jie326513988/esp32-c3-1.54-epd/(list of files, drawings)

Other design files:
ProProject_ESP32C3-1.54墨水屏-多功能_2024-05-25.epro
