jie326513988/esp32-c3-1.54-epd/(commit log)

2024-05-25 可视化BOM
2024-05-25 立创EDA工程文件
    [ProProject_ESP32C3-1.54墨水屏-多功能_2024-05-25.epro]
2024-05-25 删除文件 README.en.md
2024-05-25 新建 图片
2024-05-25 上传图片
2024-05-25 删除文件 图片/.keep
2024-05-26 3D打印外壳
2024-05-26 删除文件 .gitignore
2024-05-26 删除文件 ESP32C3-1.54EPD-SSD1608-V019.bin
2024-05-26 删除文件 ESP32C3-1.54EPD-SSD1681-V019.bin
2024-05-26 更新固件 修复图片查看器切换目录BUG
2024-05-27 删除文件 图片/烧录.png
2024-06-09 删除文件 ESP32C3-1.54EPD-SSD1608-V020.bin
2024-06-09 删除文件 ESP32C3-1.54EPD-SSD1681-V020.bin
2024-06-09 更新固件 章节列表上下页选项优化，不再乱跳 章节检索优化 闹钟列表有下一页了
2024-06-12 删除文件 ESP32C3-1.54EPD-SSD1608-V021.bin
2024-06-12 删除文件 ESP32C3-1.54EPD-SSD1681-V021.bin
2024-06-12 更新固件 优化配网性能，修复一句话表单提交后卡死BUG
2024-06-20 更新固件
2024-06-20 删除文件 ESP32C3-1.54EPD-SSD1681-V023-新增寻章功能.bin
2024-08-18 删除文件 ESP32C3-1.54EPD-SSD1681-V022.bin
2024-08-18 删除文件 ESP32C3-1.54EPD-SSD1608-V023-新增寻章功能.bin
2024-08-18 删除文件 ESP32C3-1.54EPD-SSD1608-V022.bin
2024-08-18 更新固件 1.所有列表界面按键逻辑更改，短按OK进入，短按BACK返回，短按UP/DOWN切换选项，长按UP/DOWN切换页 2.优化阅读和菜单按键逻辑，阅读界面长按BACK退出至文件管理器，短按BACK开灯，阅读菜单继续选项更改为章节选项 3.修复打开非jpg重命名的文件导致内存溢出无限重启问题
2024-08-18 删除文件 图片/按键提示.jpg
2024-08-18 修改按键提示
2024-10-14 重命名 ESP32C3-1.54EPD-SSD1608-V026.bin 为 ESP32C3-1.54EPD-SSD1608-V026_支持GBK.bin
2024-10-14 重命名 ESP32C3-1.54EPD-SSD1681-V026.bin 为 ESP32C3-1.54EPD-SSD1681-V026_支持GBK.bin
2024-10-27 删除文件 ESP32C3-1.54EPD-SSD1608-V026_支持GBK.bin
2024-10-27 删除文件 ESP32C3-1.54EPD-SSD1681-V026_支持GBK.bin
2024-10-27 优化GBK&UTF8识别
2025-03-03 删除文件 焊接辅助工具-0.6.html
2025-03-03 焊接辅助工具
2025-04-13 更新固件 1.优化EPUB兼容性，增加按键自定义功能
2025-04-13 更新固件 优化EPUB兼容性，增加按键自定义
2025-04-13 删除文件 ESP32C3-1.54EPD-SSD1681-V028_优化EPUB增加按键自定义.bin
2025-04-13 删除文件 ESP32C3-1.54EPD-SSD1608-V028_优化EPUB增加按键自定义.bin
2025-05-01 删除文件 ESP32C3-1.54EPD-SSD1608-V027_优化GBK&UTF8识别.bin
2025-05-01 删除文件 ESP32C3-1.54EPD-SSD1608-V029_优化EPUB增加按键自定义.bin
2025-05-01 删除文件 ESP32C3-1.54EPD-SSD1681-V027_优化GBK&UTF8识别.bin
2025-05-01 删除文件 ESP32C3-1.54EPD-SSD1681-V029_优化EPUB增加按键自定义.bin
2025-05-02 删除文件 ESP32C3-1.54EPD-SSD1681-V030_全新EPUB算法修复激活BUG.bin
2025-05-02 删除文件 ESP32C3-1.54EPD-SSD1608-V030_全新EPUB算法修复激活BUG.bin
2025-05-11 删除文件 ESP32C3-1.54EPD-SSD1681-V031_全新EPUB算法修复激活BUG.bin
2025-05-11 删除文件 ESP32C3-1.54EPD-SSD1608-V031_全新EPUB算法修复激活BUG.bin
2025-05-11 删除文件 ESP32C3-1.54EPD-SSD1681-V032_优化EPUB.bin
2025-05-11 删除文件 ESP32C3-1.54EPD-SSD1608-V032_优化EPUB.bin
2025-05-11 删除文件 ESP32C3-1.54EPD-SSD1608-V033_优化EPUB.bin
2025-05-11 删除文件 ESP32C3-1.54EPD-SSD1681-V033_优化EPUB.bin
